UHasselt-imo-imomec/Hybrid_E-Tattoo-Hub/BachelorProject/ppt_BP_EA-ICT_Jorissen.pdf

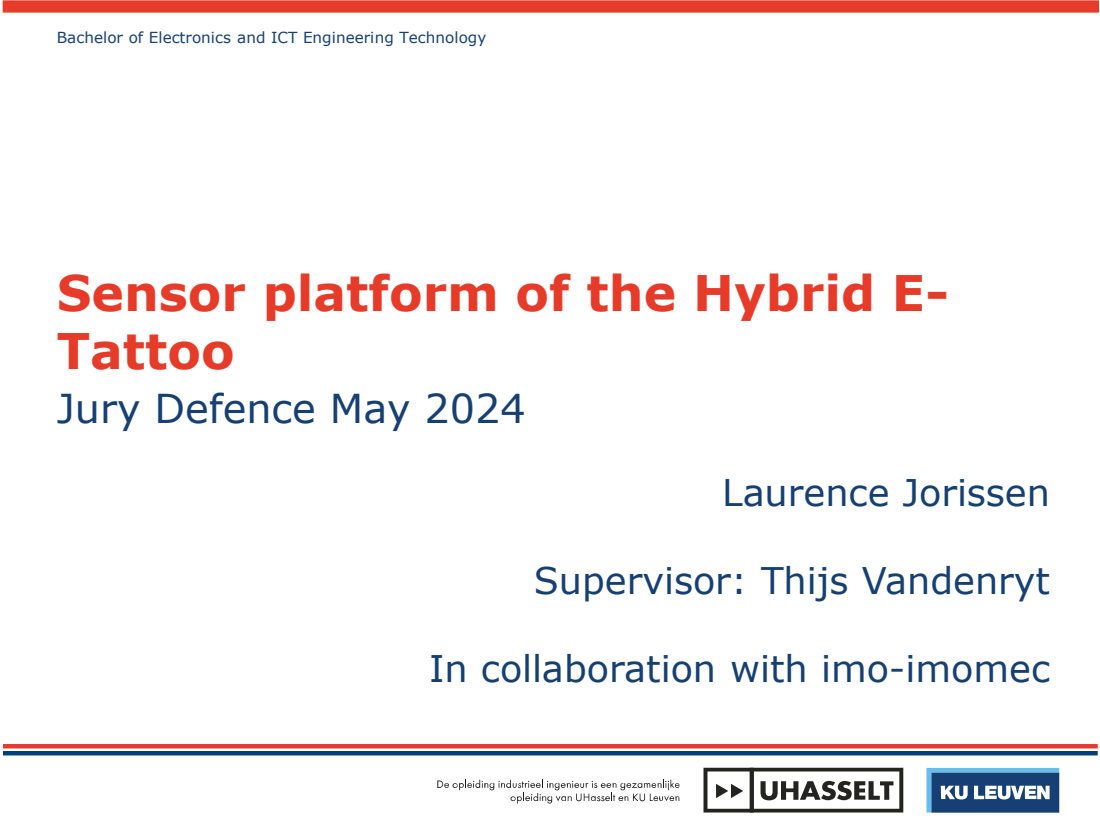
[picture p21: page 1]
Laurence Jorissen

Bachelor of Electronics and ICT Engineering Technology

Sensor platform of the Hybrid E-
Tattoo
Jury Defence May 2024

Supervisor: Thijs Vandenryt

In collaboration with imo-imomec

- The Hybrid E-Tattoo project
- Wearable Plug and Play healthcare device
- Health monitoring
- Combining smart textile and E-Tattoos (skin adhesives)

# Introduction

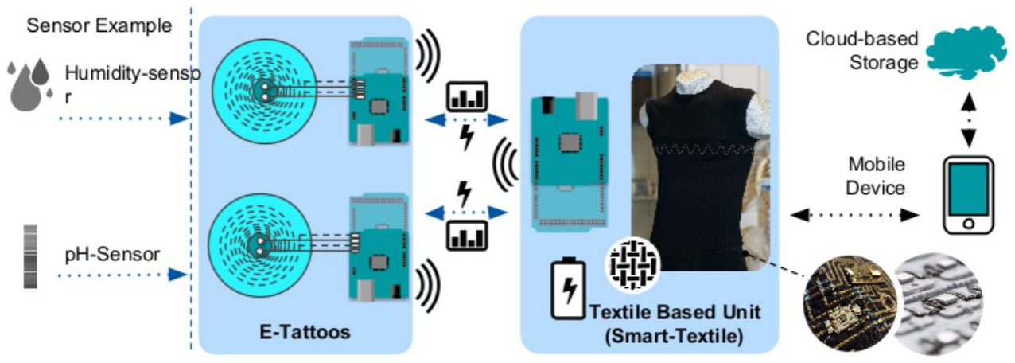
[picture p22: figure]

- The Hybrid E-Tattoo project
- Wearable plug and play healthcare device
- Health monitoring
- Combining smart textile and E-Tattoos (skin adhesives)

# Introduction

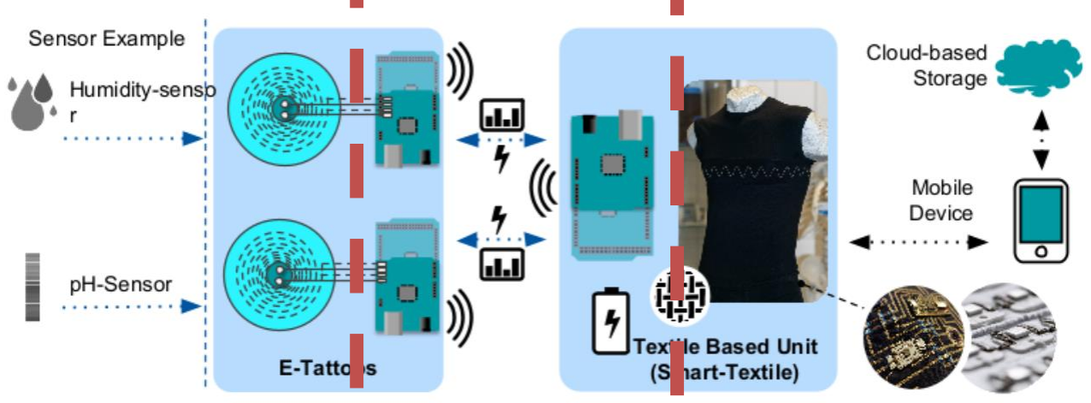
[picture p23: figure]

Sensor hub?

# Goal

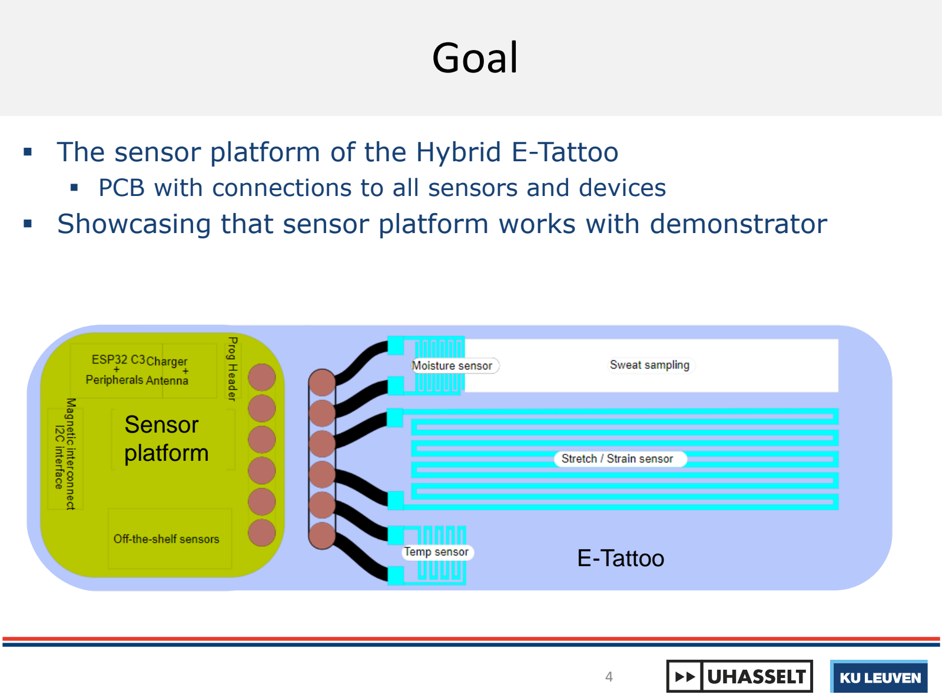
[picture p24: page 4]

- The sensor platform of the Hybrid E-Tattoo
- PCB with connections to all sensors and devices
- Showcasing that sensor platform works with demonstrator

E-Tattoo

Sensor
platform

- The demonstrator

# Materials & Results

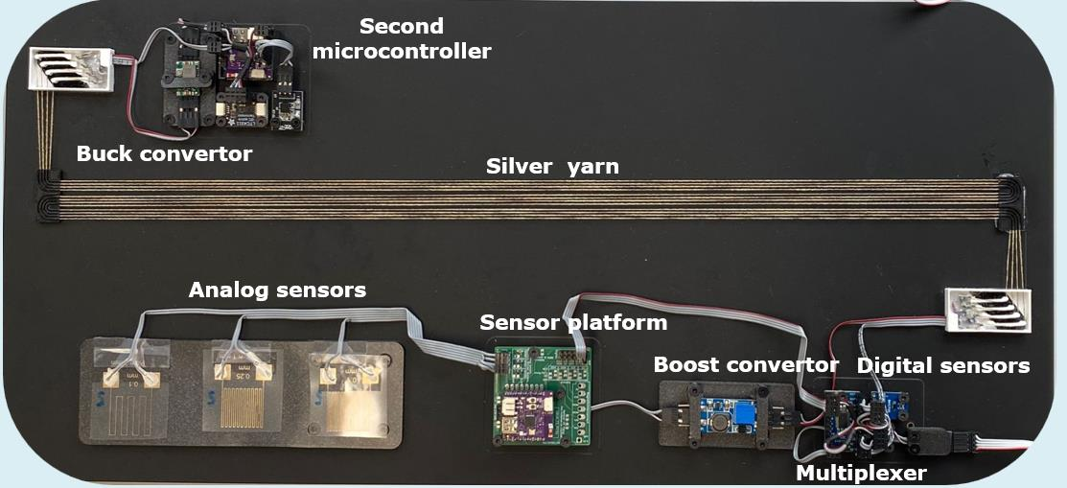
[picture p25: figure]

- The sensor platform (hub)

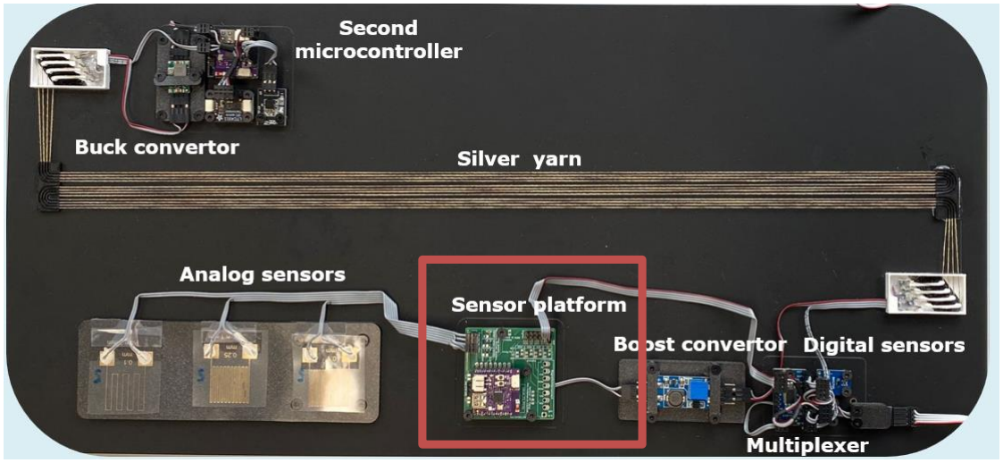
[picture p26: figure]

# Materials & Results

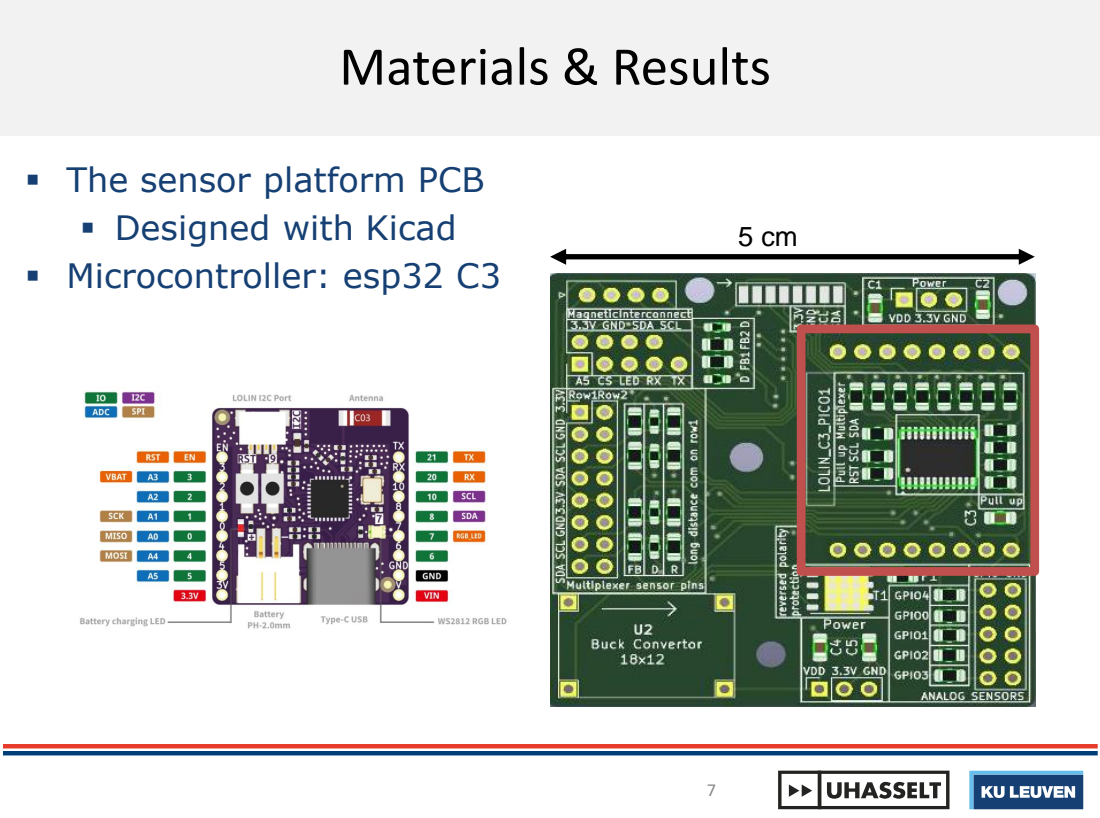
[picture p27: page 7]

▪ The sensor platform PCB
▪ Designed with Kicad
▪ Microcontroller: esp32 C3

- The analog sensors

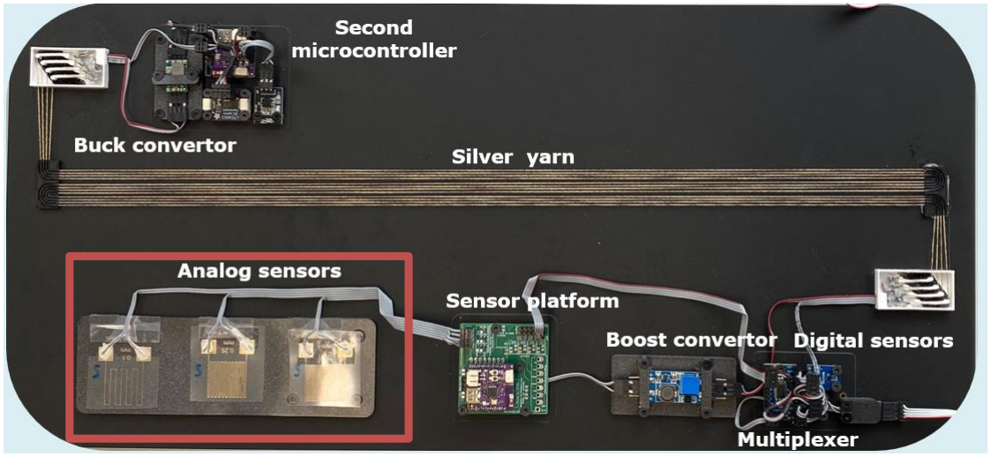
[picture p28: figure]

## - Screen printed analog Temperature sensors

# Materials & Results

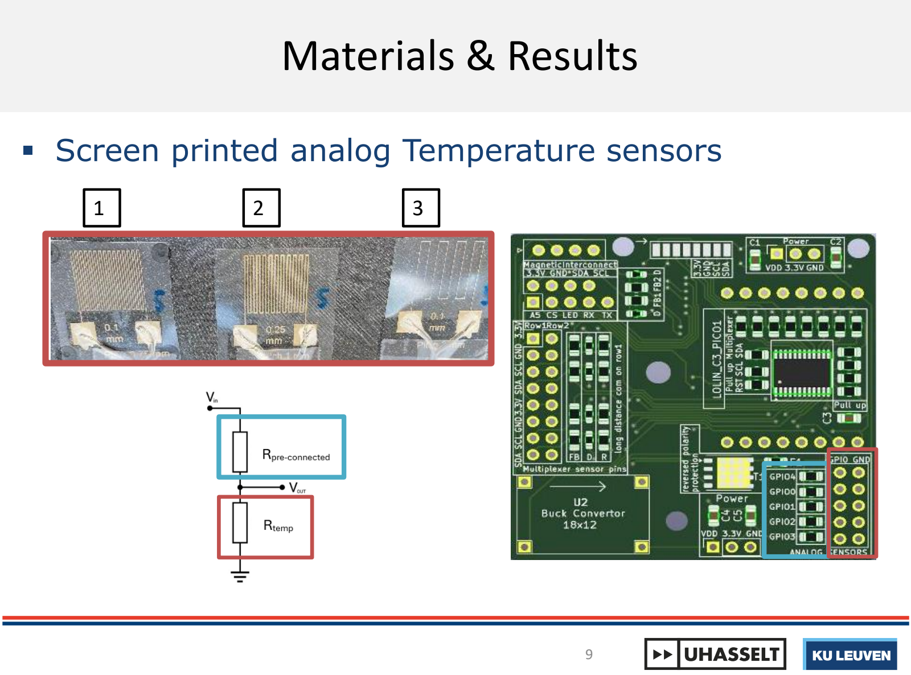
[picture p29: page 9]

1 | 2 | 3

## - Screen printed analog Temperature sensors

# Materials & Results

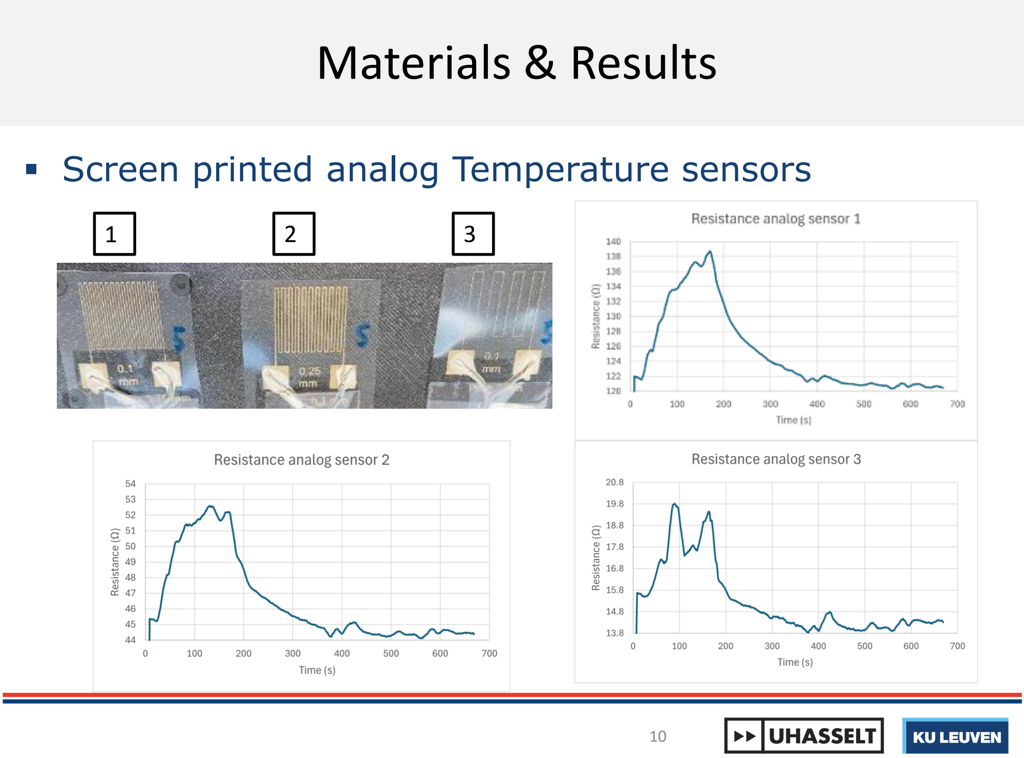
[picture p30: page 10]

1 | 2 | 3

- The digital sensors and multiplexer

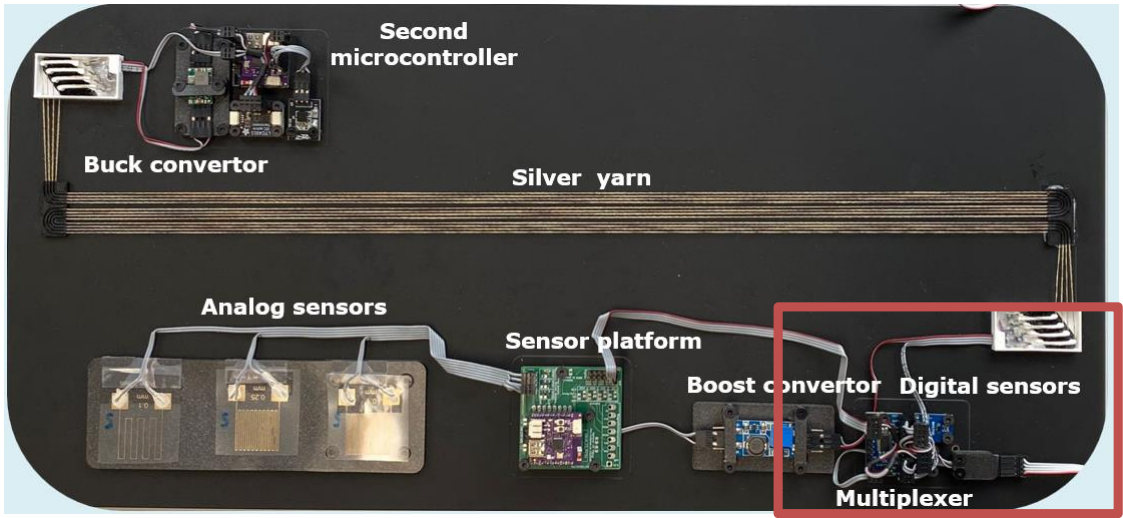
[picture p31: figure]

# Materials & Results

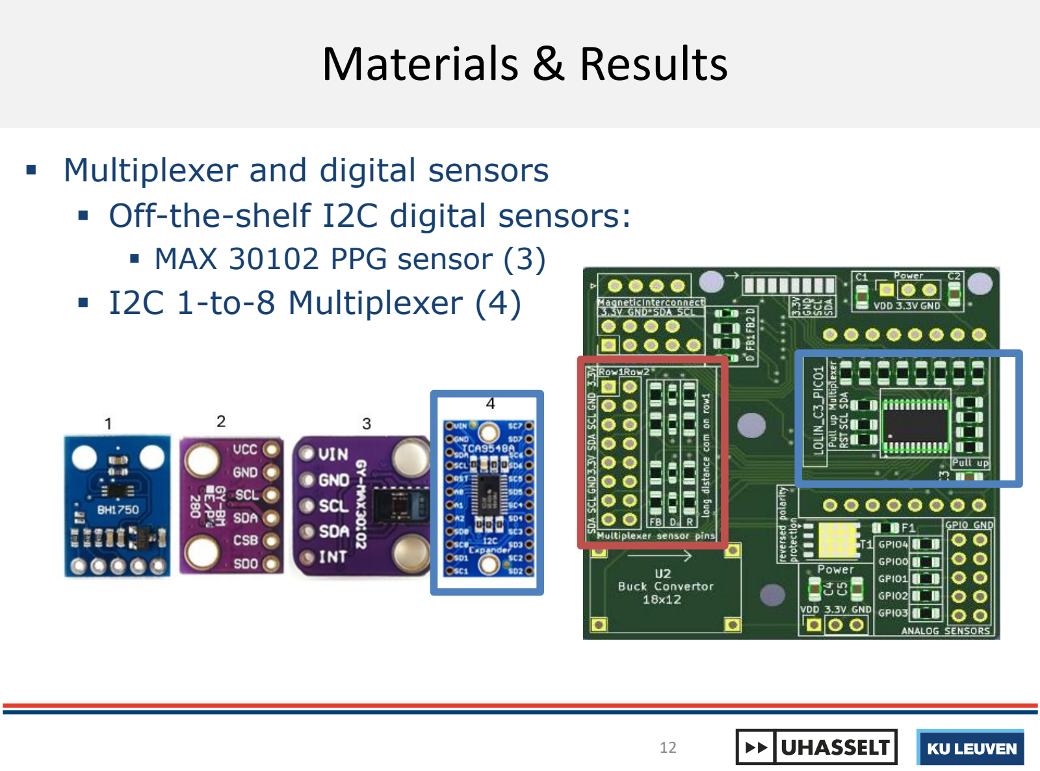
[picture p32: page 12]

### - Multiplexer and digital sensors - Off-the-shelf I2C digital sensors:

- MAX 30102 PPG sensor (3)

### - I2C 1-to-8 Multiplexer (4)

- The digital sensors and the multiplexer
- PPG sensor:
- Cable length +2 meters
- Continuous data

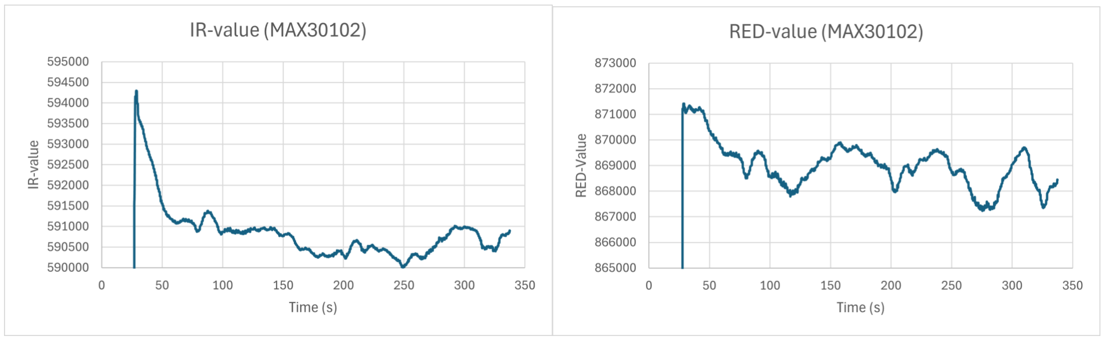
[picture p33: figure]

- The demonstrator

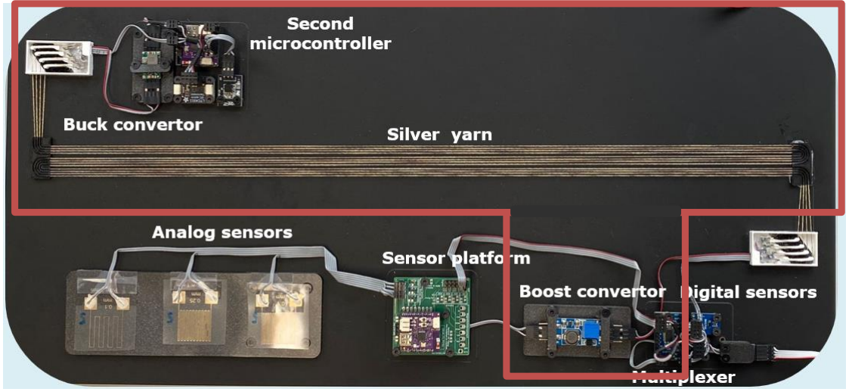
[picture p34: figure]

# Materials & Results

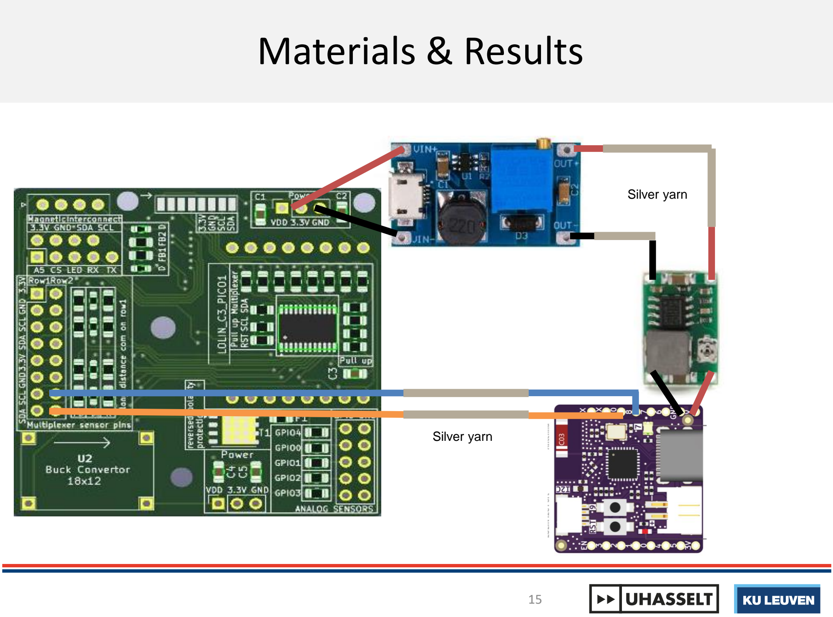
[picture p35: page 15]

Silver yarn

Silver yarn

- Communication to second microcontroller throughout silver yarn
- Here is where problems occurred
- Second microcontroller was powered and collected its data
- Unable to send its data back to sensor platform through only silver yarn (1)
- Able to send its data back through silver yarn where the ground was connected with a normal wire (2)

- Communication to second microcontroller throughout silver yarn
- Here is where problems occurred
- Second microcontroller was powered and collected its data
- Unable to send its data back to sensor platform through only silver yarn (1)
- Able to send its data back through silver yarn where the ground was connected with a normal wire (2)

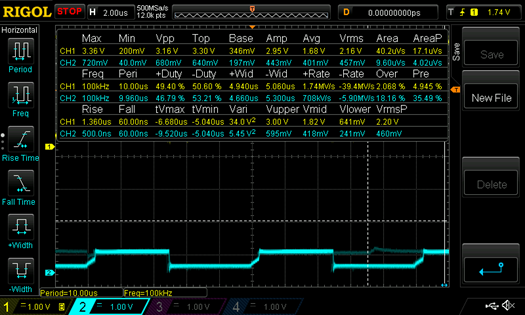
[picture p36: figure]

1

# Materials & Results

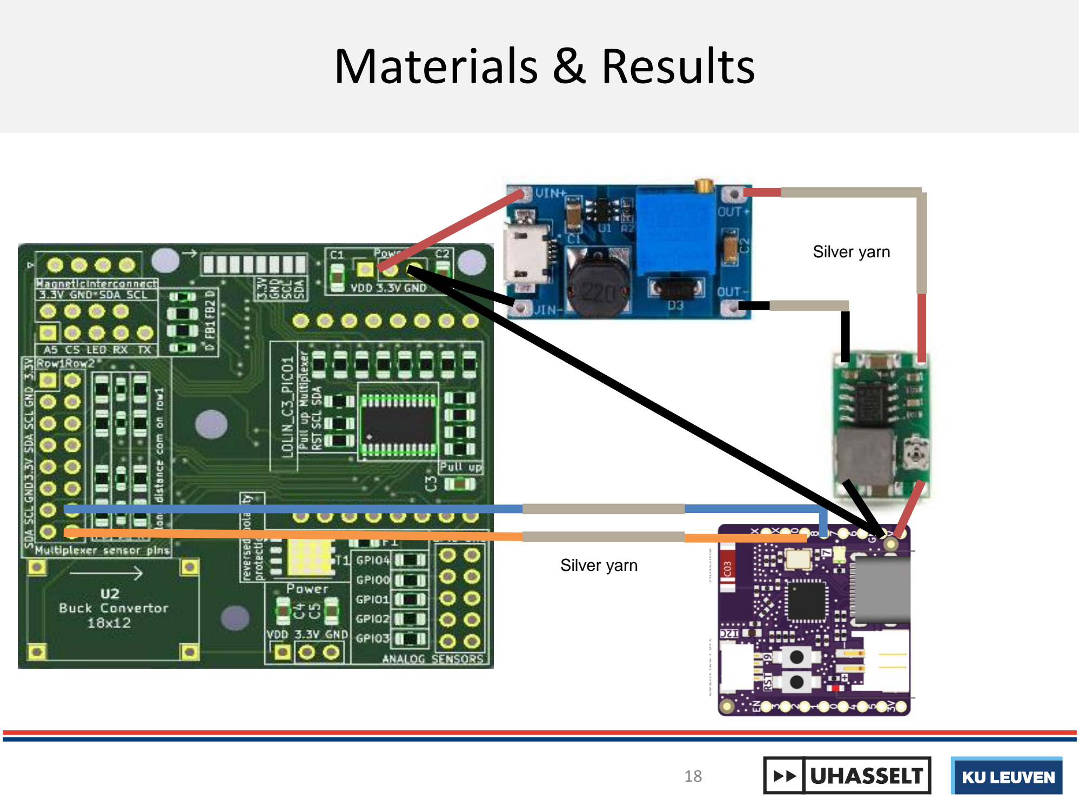
[picture p37: page 18]

Silver yarn

Silver yarn

- Communication to second microcontroller throughout silver yarn
- Here is where problems occurred
- Second microcontroller was powered and collected its data
- Unable to send its data back to sensor platform through only silver yarn (1)
- Able to send its data back through silver yarn where the ground was connected with a normal wire (2)

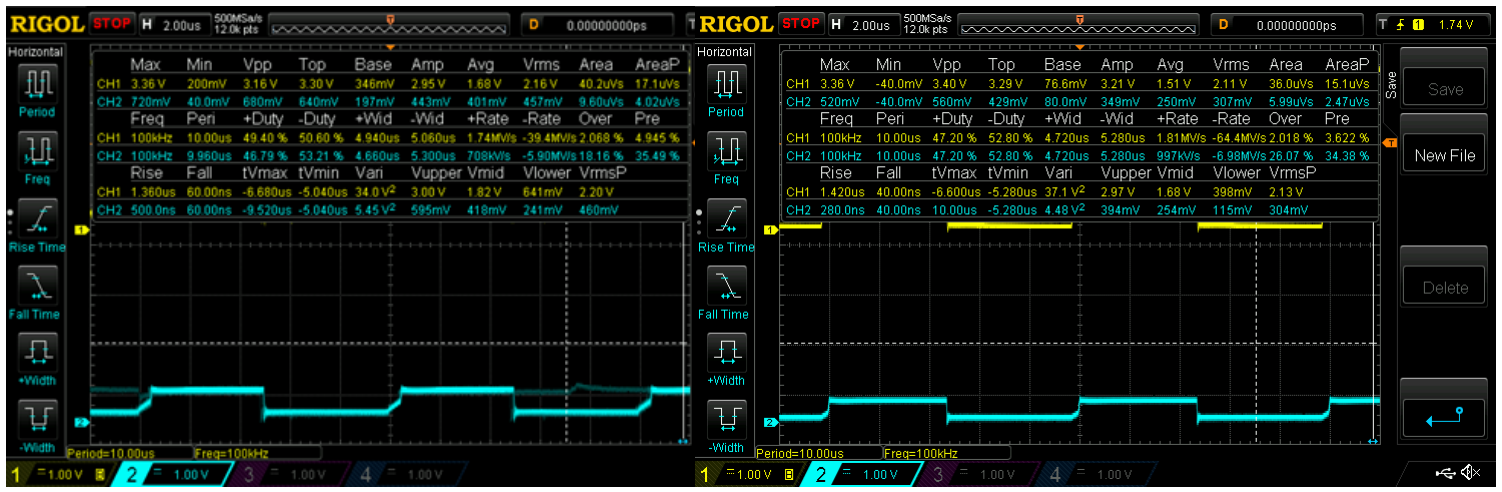
[picture p38: figure]

1 | 2

- Communication to second microcontroller throughout silver yarn
- Here is where problems occurred
- Second microcontroller was powered and collected its data
- Unable to send its data back to sensor platform through only silver yarn (1)
- Able to send its data back through silver yarn where the ground was connected with a normal wire (2)
- However, readout from sensor throughout silver yarn works

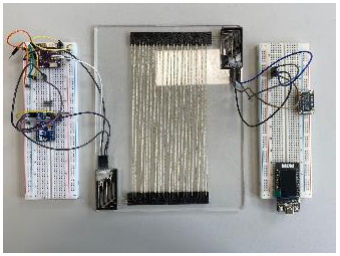
[picture p39: figure]
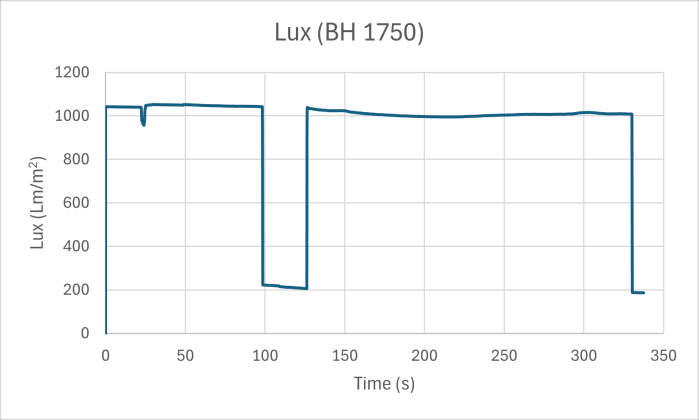
[picture p40: figure]
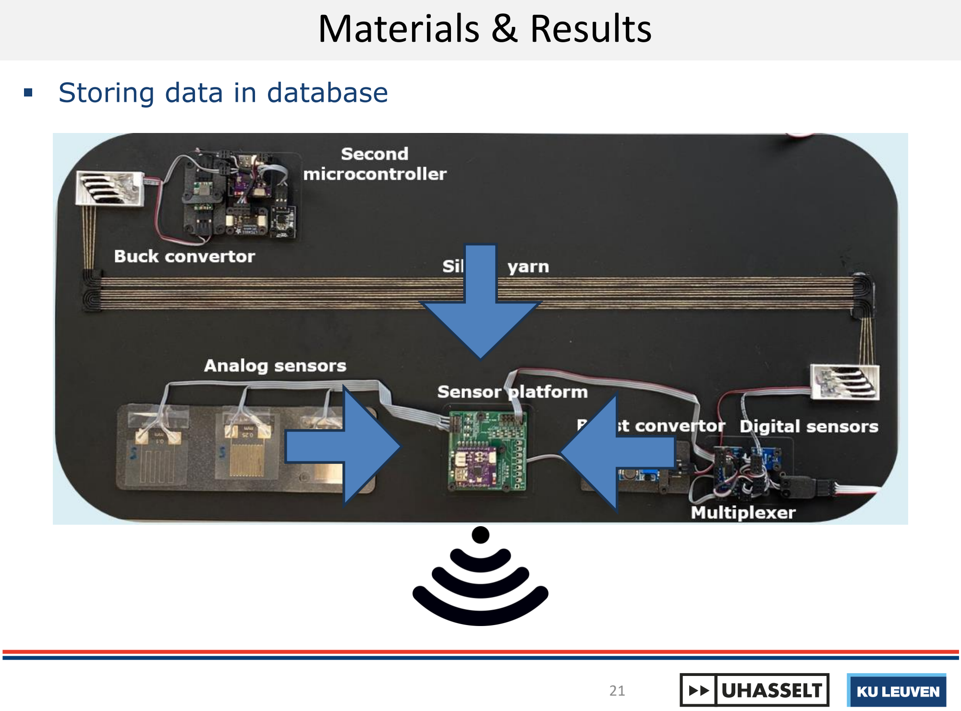
[picture p41: page 21]

- Storing data in database

## - Stroring data in database

### - InfluxDB

- Open-source time series database

# Materials & Results

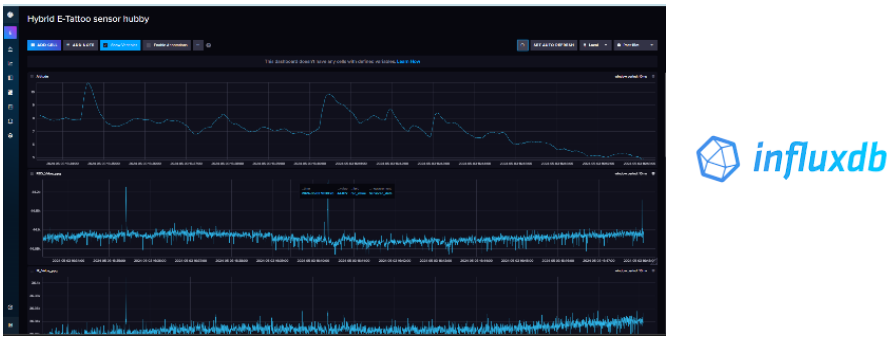
[picture p42: figure]

- The sensor platform fulfilled its role in the Hybrid E-Tattoo project
- For the readout of the sensors
- Not for the second microcontroller
- Designed from electronic perspective
- User cases introduced -> design adapted accordingly
- Room for optimalization in every part of demonstrator
- Analog sensors: Resolution can be optimized by ADC attenuation or with different pre-connected resistor values
- Digital sensors: Calibration of sensors can be optimized

# Conclusion

# Conclusion

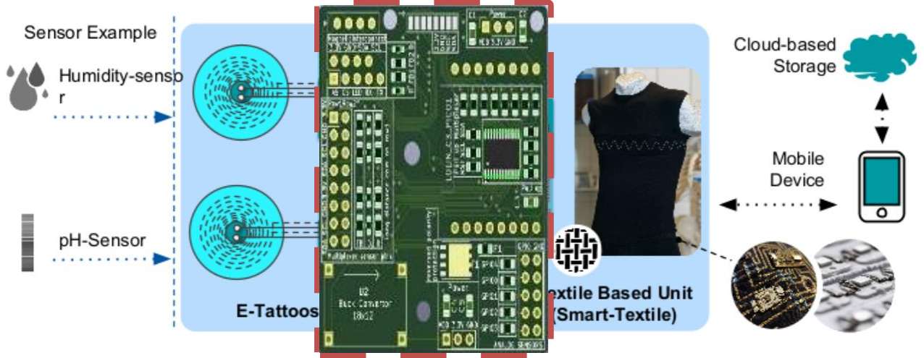
[picture p43: figure]

Sensor hub!

- The sensor platform
- 5 x 5 cm custom PCB
- Connections to all external sensors and devices
- Not of the same prototype as the one used on the demonstrator
- More optimized
- Multiplexer chip, security and long-distance communication components
- Transistor and fuse
- Pull up resistors
- Ferrite beads
- ESD suppressors

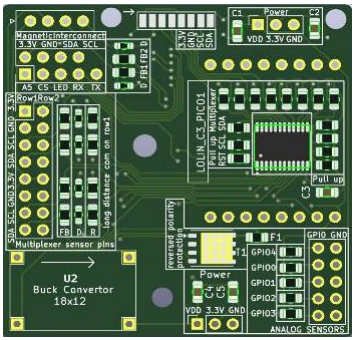
[picture p44: figure]

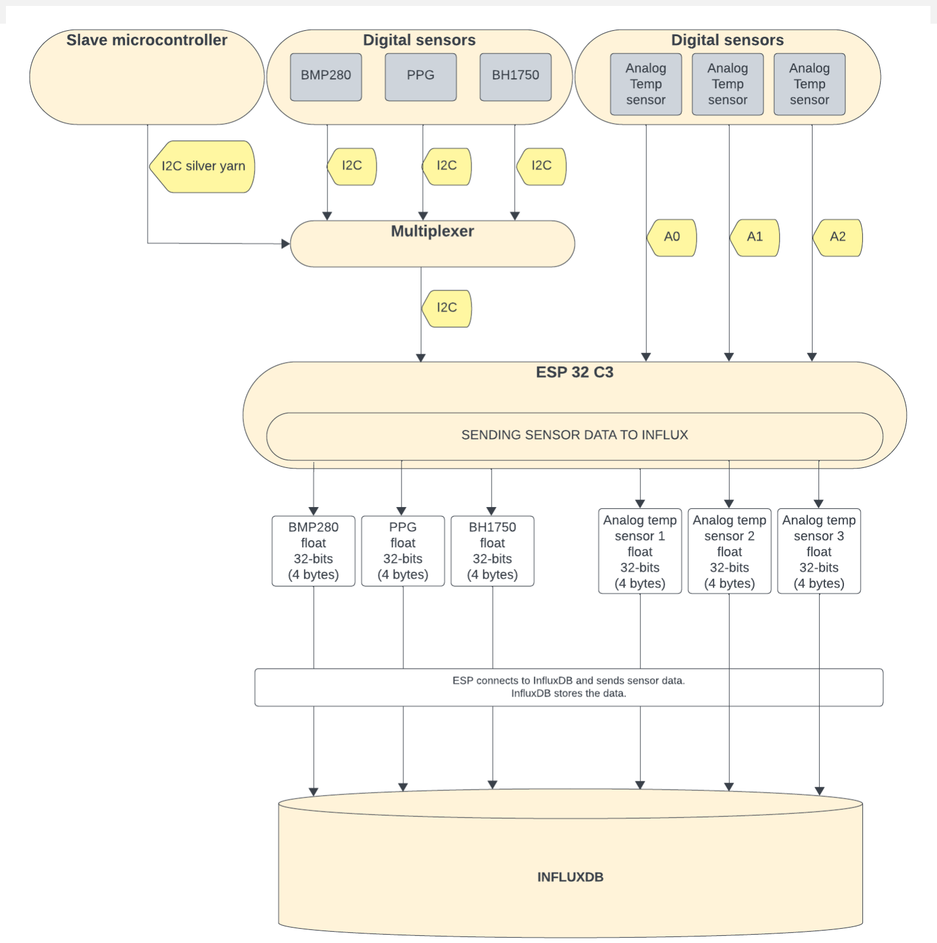
[picture p45: figure]
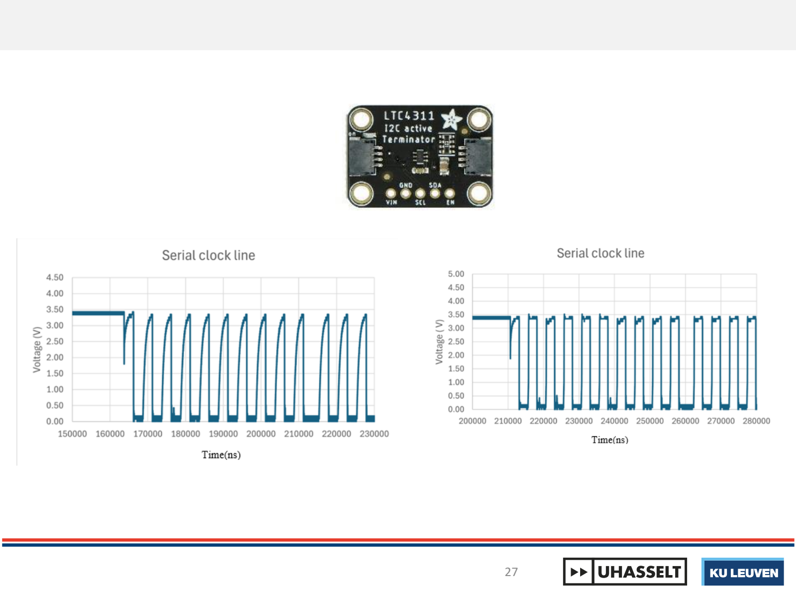
[picture p46: page 27]
