UHasselt-imo-imomec/Hybrid_E-Tattoo-Hub/Demonstrator_HardwareDesign/PCB_Laurence_V2.png

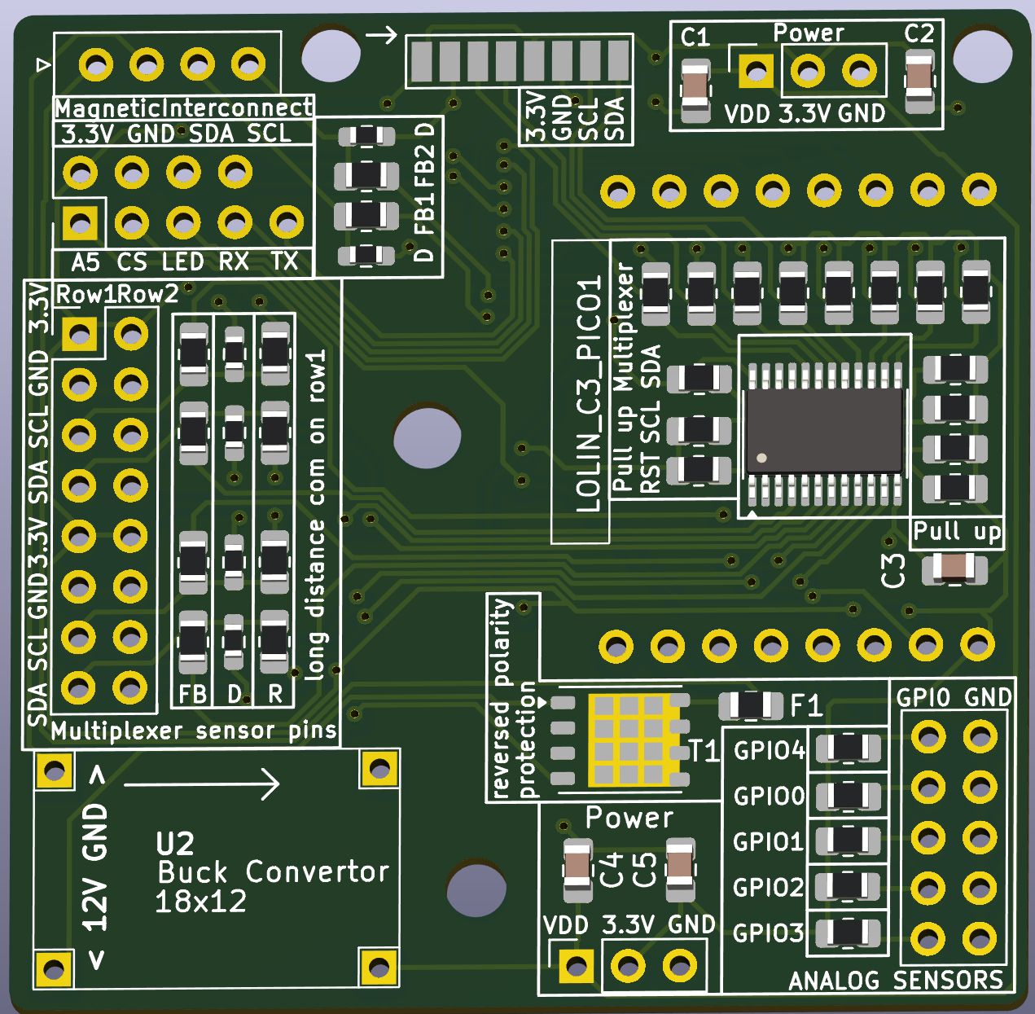
Demonstrator_HardwareDesign/PCB_Laurence_V2.png
