UHasselt-imo-imomec/Hybrid_E-Tattoo-Hub/Demonstrator_HardwareDesign/PCB_V1/CarrierPCB_Layers_Rear.png

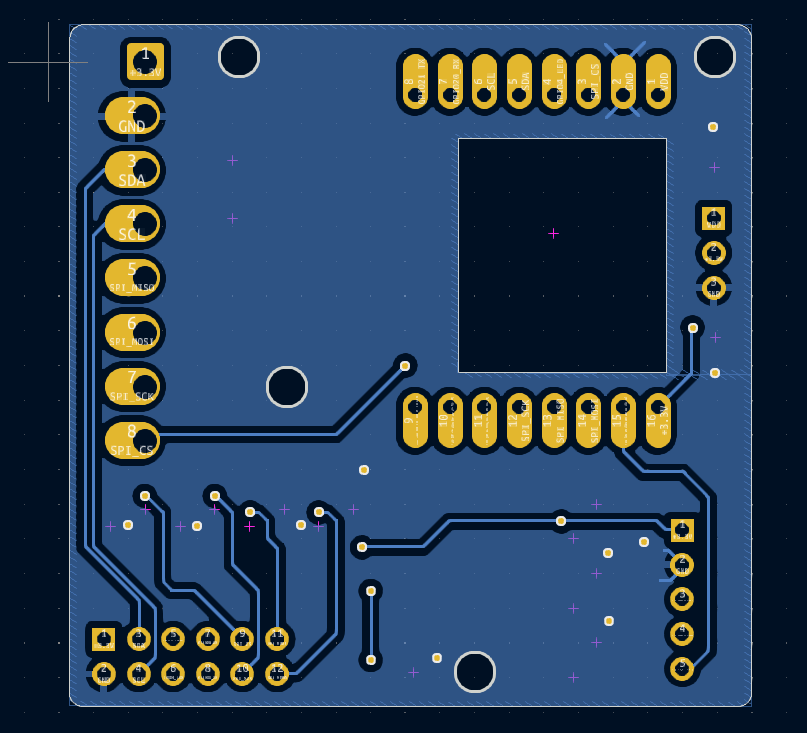
Demonstrator_HardwareDesign/PCB_V1/CarrierPCB_Layers_Rear.png
