UHasselt-imo-imomec/Hybrid_E-Tattoo-Hub/Demonstrator_HardwareDesign/Hybrid E-tattoo Hub V2_0/BOM.xls

WINKELWAGENTJE
Dit is geen factuur
29-mrt-24 05:02:43
 | Mouser-nr | Fabrikantnr | Fabrikant | Klantnummer | Omschrijving | RoHS | Levenscyclus | Besteld aantal | Prijs (EUR) | Toestel: (EUR)
1 | 595-TCA9548APWR | TCA9548APWR | Texas Instruments |  | Schakelaar IC&apos;s - Diversen 8-Channel I2C Switch | RoHS-conformiteit |  | 5 | 1,49 € | 7,45 €
2 | 710-742792693 | 742792693 | Wurth Elektronik |  | Ferrietparels WE-CBF 0603 100MHz 2200Ohm 50mA AEC-Q200 | RoHS-conformiteit |  | 30 | 0,17 € | 5,10 €
3 | 581-08056C106MAT2A | 08056C106MAT2A | KYOCERA AVX |  | Meerlaagse keramische condensatoren MLCC - SMD/SMT 6.3V 10uF X7R 0805 20% | RoHS-conformiteit |  | 30 | 0,117 € | 3,51 €
4 | 755-VS3V3BL1HST15R | VS3V3BL1HST15R | ROHM Semiconductor |  | ESD-onderdrukkers/TVS-diodes TVS DIODE HI-SURGE RESISTANCE | RoHS-conformiteit |  | 30 | 0,229 € | 6,87 €
5 | 708-RNCP0805FTD10K0 | RNCP0805FTD10K0 | SEI Stackpole |  | Weerstanden met dunne folie - SMD 10KOhms 0805 0.25W 100ppm 1% Hi Pwr Anti-Sulfur | RoHS-conformiteit | Nieuw bij Mouser | 50 | 0,021 € | 1,05 €
6 | 603-RT0805FRE073K3L | RT0805FRE073K3L | YAGEO |  | Weerstanden met dunne folie - SMD 1/8W 3.3K ohm 1% 50ppm | RoHS-conform per uitzondering |  | 50 | 0,027 € | 1,35 €
7 | 603-RT0805FRE071KL | RT0805FRE071KL | YAGEO |  | Weerstanden met dunne folie - SMD 1/8W 1K ohm 1% 50ppm | RoHS-conform per uitzondering |  | 50 | 0,027 € | 1,35 €
8 | 726-BSZ086P03NS3GXT | BSZ086P03NS3GXT | Infineon |  | MOSFET P-Ch -30V 13.5A TSDSON-8 OptiMOS P3 | RoHS-conformiteit |  | 10 | 0,654 € | 6,54 €
9 | 581-F0805B0R50FSTR | F0805B0R50FSTR | KYOCERA AVX |  | Opbouwzekeringen 0805 0.5AMPS SMD | RoHS-conformiteit |  | 10 | 0,483 € | 4,83 €
Door uw bestelling te verzenden, gaat u akkoord met deze bepalingen en voorwaarden. (https://eu.mouser.com/saleterms) |  |  |  |  |  |  |  |  | Aangekochte artikelen: | 38,05 €
De getoonde prijzen zijn gekoppeld aan de weergegeven datum en tijd. |  |  |  |  |  |  |  |  | Verzendkosten: | 20,00 €
