UHasselt-imo-imomec/Hybrid_E-Tattoo-Hub/Data/Data_ppg_ESP32C3/Derde test data met klipper/ppg_data_met_klipper.xlsx

Sheet: ppg data lange afstand alle sen
Column1 | Column2 | Column3
318696 | 595588 | 869345
318826 | 595593 | 869346
318956 | 595577 | 869357
319086 | 595590 | 869355
319217 | 595505 | 869051
319365 | 595499 | 869047
319495 | 595495 | 869042
319625 | 595494 | 869045
319755 | 595497 | 869049
319886 | 595505 | 869043
320016 | 595517 | 868974
320146 | 595521 | 868971
320276 | 595526 | 868973
320406 | 595524 | 868966
320541 | 595517 | 868968
320671 | 595524 | 868970
320801 | 595590 | 869130
320931 | 595603 | 869134
321062 | 595600 | 869144
321192 | 595592 | 869132
321323 | 595582 | 869103
321453 | 595564 | 869040
321584 | 595564 | 868943
321714 | 595568 | 868969
321844 | 595573 | 868977
321975 | 595570 | 868987
322105 | 595574 | 868999
322236 | 595582 | 869012
322366 | 595554 | 868913
322497 | 595560 | 868921
322632 | 595562 | 868923
322762 | 595568 | 868941
322893 | 595568 | 868942
323023 | 595577 | 868990
323153 | 595575 | 868986
323284 | 595574 | 868981
323414 | 595573 | 868982
323545 | 595572 | 868997
323675 | 595574 | 868992
323806 | 595647 | 869217
323936 | 595645 | 869220
324067 | 595653 | 869249
324197 | 595655 | 869256
324328 | 595661 | 869275
324458 | 595664 | 869278
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
