UHasselt-imo-imomec/Hybrid_E-Tattoo-Hub/Data/Data_ppg_ESP32C3/Eerste test data/PPG_data op korte afstand.csv

#! | Workbook: | Custom | Custom
#! | Deze gegevens afspelen: open het oorspronkelijke Excel-werkmapbestand | klik op de knop *Gegevensbestand importeren* op het lint *Data Streamer* en navigeer naar dit bestand.
#! | Ga naar http://aka.ms/hackingstem/ voor meer informatie
1431424 | 1986666
1431432 | 1986665
1431433 | 1986667
1431429 | 1986659
1431435 | 1986662
1431432 | 1986654
1431434 | 1986662
1431433 | 1986664
1431425 | 1986656
1431430 | 1986657
1431435 | 1986659
1431436 | 1986657
1431426 | 1986650
1431445 | 1986617
1431436 | 1986650
1431426 | 1986664
1431426 | 1986660
1431427 | 1986658
1431437 | 1986655
1431433 | 1986670
1431439 | 1986667
1431430 | 1986645
1431423 | 1986654
1431428 | 1986658
1431425 | 1986653
1431434 | 1986663
1431425 | 1986640
1431422 | 1986658
1431426 | 1986663
1431425 | 1986652
1431423 | 1986658
1431428 | 1986659
1431425 | 1986650
1431426 | 1986658
1431424 | 1986650
1431429 | 1986661
1431438 | 1986671
1431426 | 1986662
1431430 | 1986660
1431430 | 1986659
1431428 | 1986647
1431429 | 1986654
1431426 | 1986653
1431426 | 1986655
1431434 | 1986603
1431417 | 1986648
1431428 | 1986656
1431428 | 1986641
1431428 | 1986654
1431428 | 1986658
1431427 | 1986661
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
