UHasselt-imo-imomec/Hybrid_E-Tattoo-Hub/Data/Data_ppg_ESP32C3/Eerste test data/PPG_data op lange afstand zonder LTC.csv

#! | Workbook: | Custom | Custom
#! | Deze gegevens afspelen: open het oorspronkelijke Excel-werkmapbestand | klik op de knop *Gegevensbestand importeren* op het lint *Data Streamer* en navigeer naar dit bestand.
#! | Ga naar http://aka.ms/hackingstem/ voor meer informatie
1150719 | 1703317
1150709 | 1703317
1150721 | 1703260
1150715 | 1703298
1150719 | 1703310
1150709 | 1703291
1150716 | 1703301
1150713 | 1703299
1150702 | 1703292
1150722 | 1703313
1150693 | 1703279
1150703 | 1703275
1150702 | 1703273
1150700 | 1703281
1150705 | 1703265
1150712 | 1703292
1150696 | 1703287
1150692 | 1703276
1150690 | 1703282
1150679 | 1703266
1150691 | 1703273
1150686 | 1703271
1150674 | 1703254
1150684 | 1703281
1150680 | 1703262
1150665 | 1703240
1150679 | 1703255
1150689 | 1703251
1150679 | 1703261
1150686 | 1703258
1150675 | 1703255
1150683 | 1703253
1150687 | 1703272
1150686 | 1703192
1150673 | 1703250
1150677 | 1703243
1150677 | 1703239
1150675 | 1703244
1150679 | 1703242
1150686 | 1703238
1150688 | 1703243
1150645 | 1703195
1150646 | 1703189
1150645 | 1703192
1150645 | 1703194
1150641 | 1703183
1150642 | 1703179
1150641 | 1703159
1150647 | 1703186
1150622 | 1703156
1150639 | 1703177
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
