UHasselt-imo-imomec/Hybrid_E-Tattoo-Hub/Data/Data_ppg_ESP32C3/Eerste test data/PPG_data op super lange afstand met LTC zonder mult.csv

#! | Workbook: | Custom | Custom
#! | Deze gegevens afspelen: open het oorspronkelijke Excel-werkmapbestand | klik op de knop *Gegevensbestand importeren* op het lint *Data Streamer* en navigeer naar dit bestand.
#! | Ga naar http://aka.ms/hackingstem/ voor meer informatie
1131122 | 1423428
1131116 | 1423428
1131119 | 1423423
1131116 | 1423427
1131115 | 1423427
1131119 | 1423428
1131119 | 1423430
1131111 | 1423432
1131121 | 1423430
1131123 | 1423436
1131116 | 1423426
1131119 | 1423427
1131119 | 1423425
1131116 | 1423424
1131119 | 1423418
1131096 | 1423387
1131097 | 1423393
1131102 | 1423394
1131096 | 1423395
1131127 | 1423431
1131119 | 1423420
1131121 | 1423436
1131128 | 1423424
1131111 | 1423426
1131122 | 1423432
1131121 | 1423423
1131118 | 1423426
1131121 | 1423420
1131115 | 1423417
1131120 | 1423431
1131111 | 1423433
1131108 | 1423423
1131114 | 1423426
1131120 | 1423428
1131120 | 1423425
1131120 | 1423432
1131119 | 1423429
1131122 | 1423424
1131117 | 1423434
1131132 | 1423430
1131125 | 1423433
1131116 | 1423427
1131119 | 1423436
1131121 | 1423428
1131120 | 1423423
1131122 | 1423429
1131121 | 1423433
1131121 | 1423428
1131123 | 1423429
1131122 | 1423434
1131123 | 1423429
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
