UHasselt-imo-imomec/Hybrid_E-Tattoo-Hub/Data/Data_ppg_ESP32C3/Eerste test data/PPG_data op super lange afstand zonder LTC en zonder Multiplexer.csv

#! | Workbook: | Custom | Custom
#! | Deze gegevens afspelen: open het oorspronkelijke Excel-werkmapbestand | klik op de knop *Gegevensbestand importeren* op het lint *Data Streamer* en navigeer naar dit bestand.
#! | Ga naar http://aka.ms/hackingstem/ voor meer informatie
1162632 | 1990161
1162627 | 1990168
1162624 | 1990167
1162631 | 1990171
1162632 | 1990163
1162626 | 1990176
1162631 | 1990173
1162640 | 1990172
1162634 | 1990172
1162638 | 1990172
1162640 | 1990168
1162631 | 1990171
1162622 | 1990168
1162638 | 1990179
1162629 | 1990177
1162635 | 1990166
1162629 | 1990172
1162636 | 1990169
1162629 | 1990164
1162624 | 1990171
1162633 | 1990167
1162631 | 1990167
1162632 | 1990164
1162629 | 1990176
1162630 | 1990162
1162628 | 1990172
1162630 | 1990171
1162626 | 1990164
1162626 | 1990166
1162629 | 1990171
1162631 | 1990174
1162624 | 1990168
1162619 | 1990173
1162629 | 1990175
1162634 | 1990167
1162633 | 1990178
1162632 | 1990186
1162641 | 1990172
1162629 | 1990178
1162626 | 1990173
1162635 | 1990158
1162628 | 1990174
1162626 | 1990170
1162629 | 1990172
1162632 | 1990157
1162627 | 1990166
1162641 | 1990176
1162624 | 1990174
1162628 | 1990173
1162624 | 1990174
1162622 | 1990159
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
