UHasselt-imo-imomec/Hybrid_E-Tattoo-Hub/Data/Data_ppg_ESP32C3/Derde test data met klipper/IR-Value met klipper.jpg

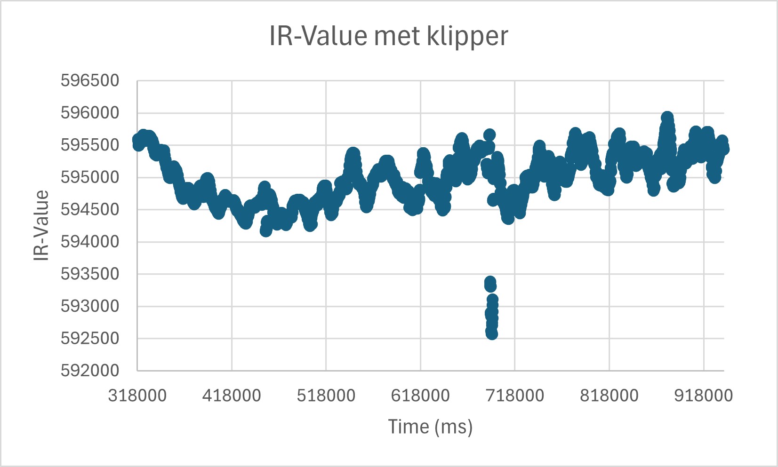
Data/Data_ppg_ESP32C3/Derde test data met klipper/IR-Value met klipper.jpg
