UHasselt-imo-imomec/Hybrid_E-Tattoo-Hub/Data/Data_ppg_ESP32C3/Eerste test data/PPG sensor op korte afstand.jpg

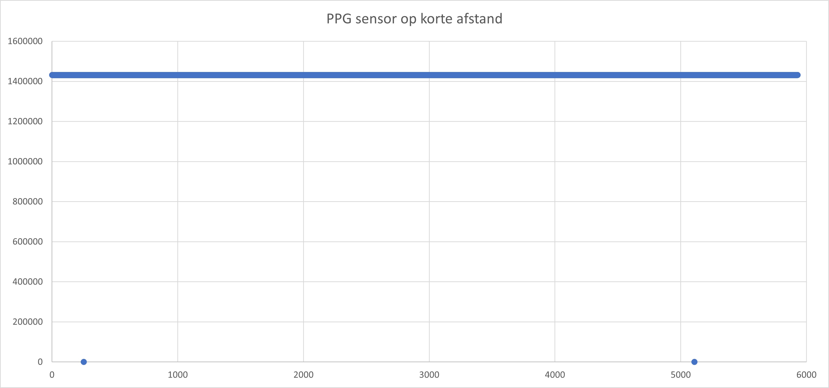
Data/Data_ppg_ESP32C3/Eerste test data/PPG sensor op korte afstand.jpg
