UHasselt-imo-imomec/Hybrid_E-Tattoo-Hub/Data/Data_ppg_ESP32C3/Eerste test data/PPG sensor op super lange afstand zonder LTC4311.jpg

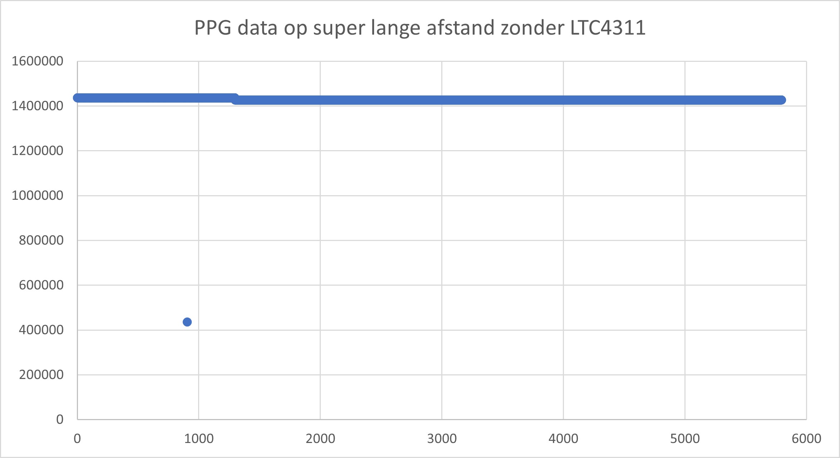
Data/Data_ppg_ESP32C3/Eerste test data/PPG sensor op super lange afstand zonder LTC4311.jpg
