UHasselt-imo-imomec/Hybrid_E-Tattoo-Hub/Data/Data_ppg_ESP32C3/Eerste test data/red_value zonder etc zonder multi.jpg

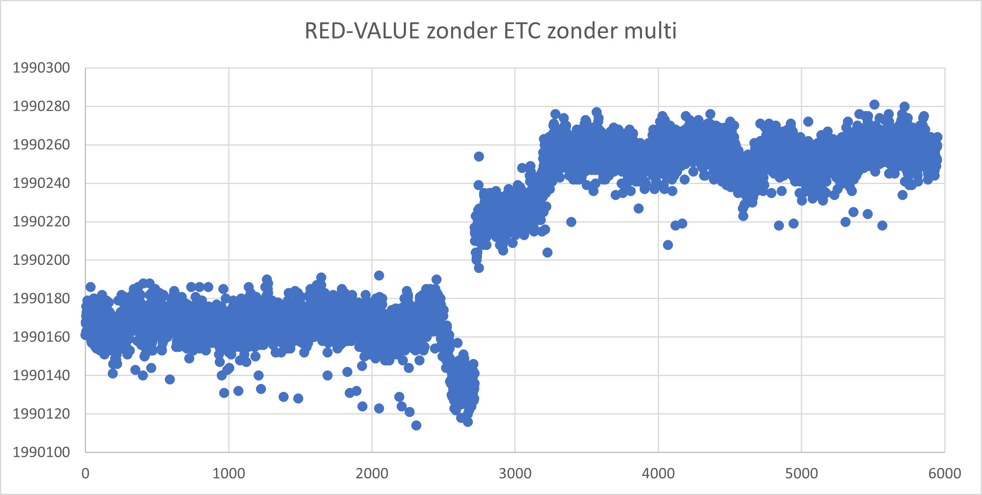
Data/Data_ppg_ESP32C3/Eerste test data/red_value zonder etc zonder multi.jpg
