UHasselt-imo-imomec/Hybrid_E-Tattoo-Hub/Data/Data_ppg_ESP32C3/Tweede test data/alle sensoren met multiplexer/IR-Value korte afstand.jpg

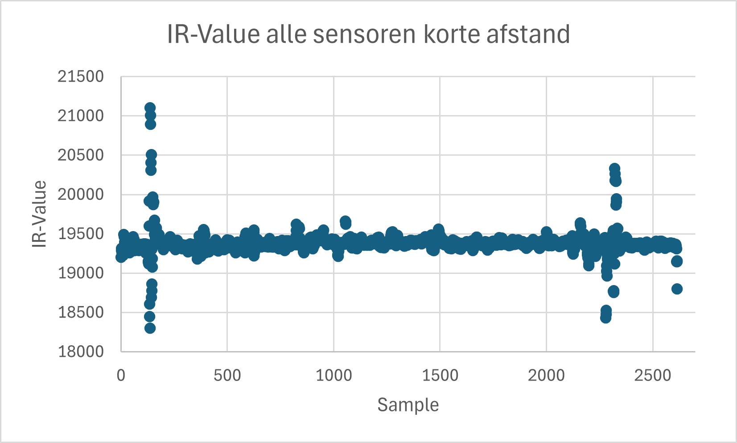
Data/Data_ppg_ESP32C3/Tweede test data/alle sensoren met multiplexer/IR-Value korte afstand.jpg
