UHasselt-imo-imomec/Hybrid_E-Tattoo-Hub/Data/Data_ppg_ESP32C3/Tweede test data/Alleen ppg sensor/IR-Value korte afstand.jpg

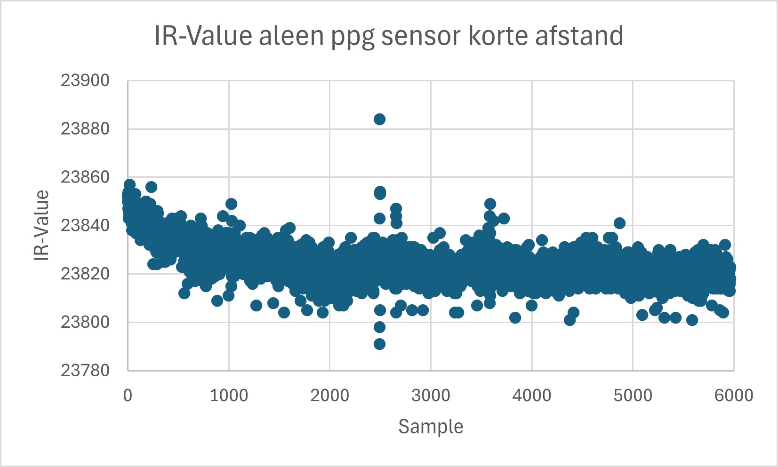
Data/Data_ppg_ESP32C3/Tweede test data/Alleen ppg sensor/IR-Value korte afstand.jpg
