UHasselt-imo-imomec/Hybrid_E-Tattoo-Hub/Data/Data_ppg_ESP32C3/Tweede test data/Alleen ppg sensor/RED-value lange afstand.jpg

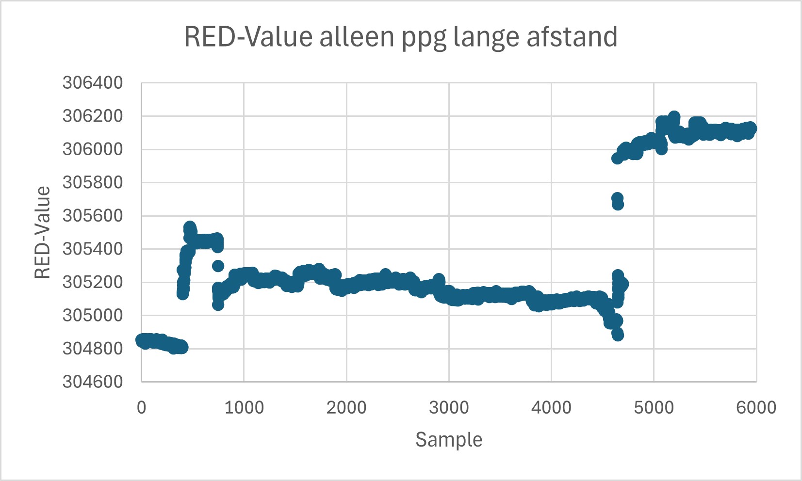
Data/Data_ppg_ESP32C3/Tweede test data/Alleen ppg sensor/RED-value lange afstand.jpg
