UHasselt-imo-imomec/Hybrid_E-Tattoo-Hub/Data/Dataflow/Dataflow_esp32.pdf

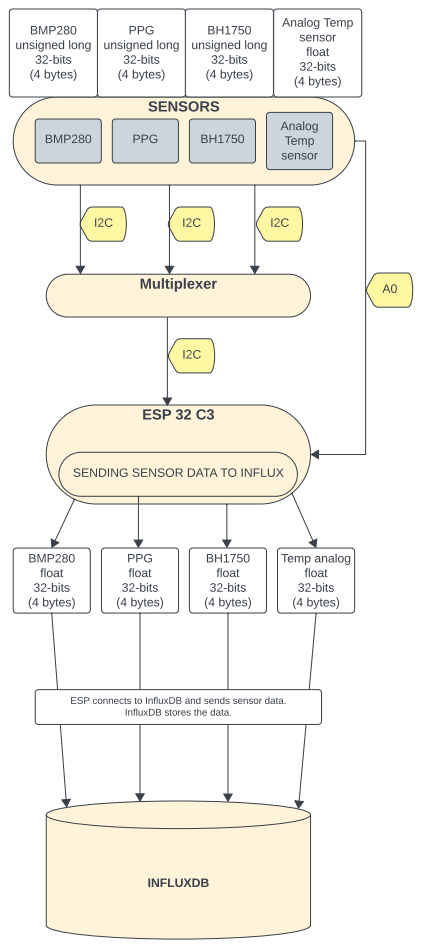
[picture p68: page 1]
ESP 32 C3; SENSORS; BMP280; PPG; INFLUXDB; Multiplexer; Analog Temp sensor; BMP280 float 32-bits (4 bytes); PPG unsigned long 32-bits (4 bytes); BH1750 unsigned long 32-bits (4 bytes); BMP280 unsigned long 32-bits (4 bytes); PPG float 32-bits (4 bytes); BH1750 float 32-bits (4 bytes); Temp analog float 32-bits (4 bytes); Analog Temp sensor float 32-bits (4 bytes)

SENDING SENSOR DATA TO INFLUX

ESP connects to InfluxDB and sends sensor data.

InfluxDB stores the data.
