UHasselt-imo-imomec/Hybrid_E-Tattoo-Hub/Demonstrator_HardwareDesign/Hybrid E-tattoo Hub V2_0/EHealth_PCB.kicad_pcb

## KiCad design Demonstrator_HardwareDesign/Hybrid E-tattoo Hub V2_0/EHealth_PCB.kicad_pcb (2024-10-08)

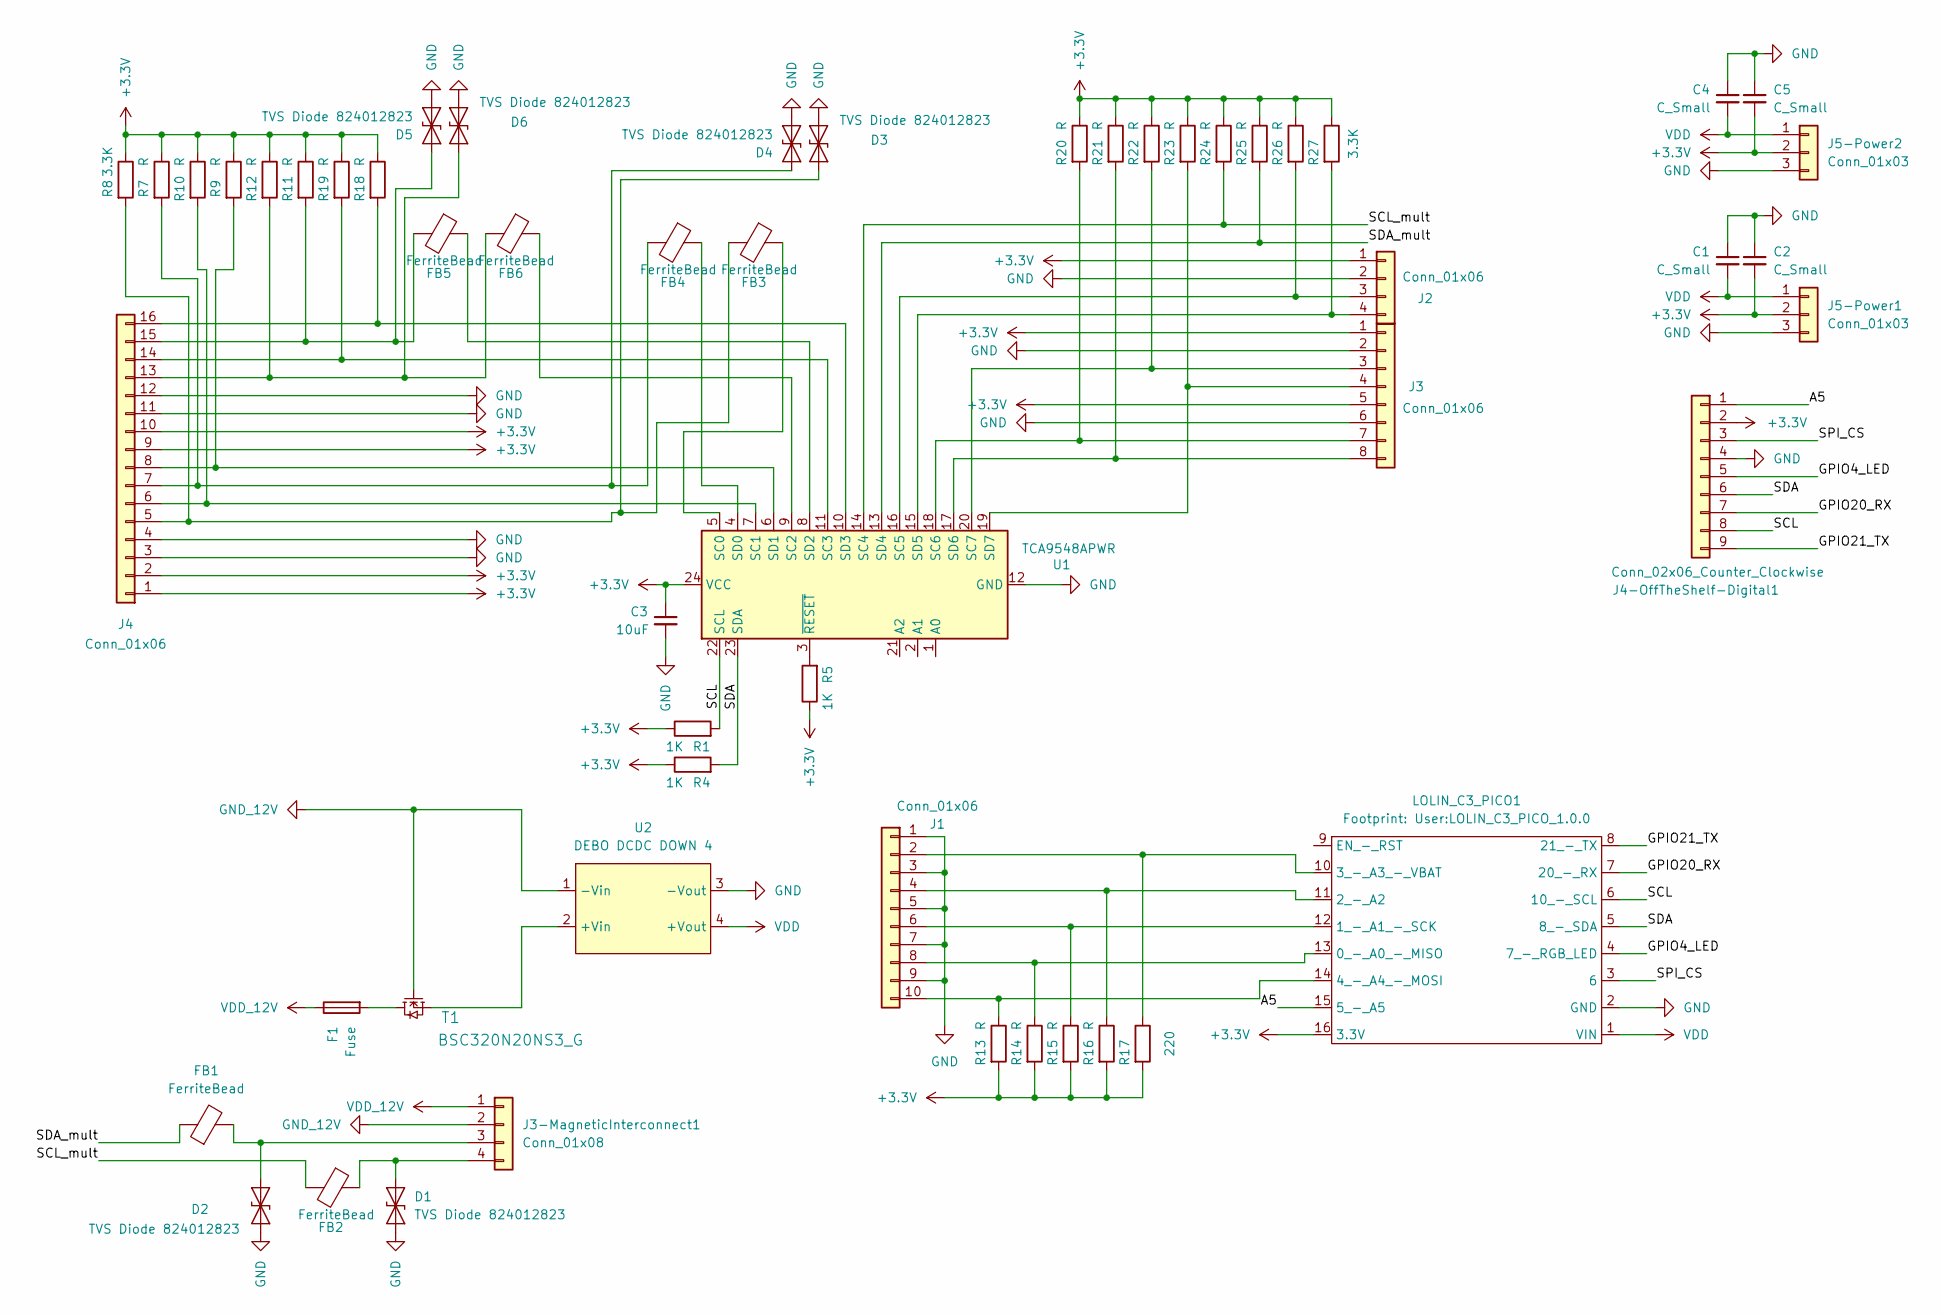
[picture p69: schematic EHealth_PCB.kicad_sch]

Parts:
C1, C2, C4, C5: C_Small; C_0805_2012Metric_Pad1.18x1.45mm_HandSolder
C3: 10uF; C_0805_2012Metric_Pad1.18x1.45mm_HandSolder
D1, D2, D3, D4, D5, D6: TVS Diode 824012823; R_0603_1608Metric_Pad0.98x0.95mm_HandSolder
F1: Fuse; Fuse_0805_2012Metric_Pad1.15x1.40mm_HandSolder
FB1, FB2, FB3, FB4, FB5, FB6: FerriteBead; R_0805_2012Metric_Pad1.20x1.40mm_HandSolder
J1: Conn_01x06; PinHeader_2x05_P2.54mm_Vertical
J2: Conn_01x06; PinHeader_1x04_P2.54mm_Vertical
J3: Conn_01x06; PinHeader_1x08_P2.54mm_Vertical
J3-MagneticInterconnect1: Conn_01x08; JST_VH_B4P-VH-B_1x04_P3.96mm_Vertical
J4: Conn_01x06; PinHeader_2x08_P2.54mm_Vertical
J4-OffTheShelf-Digital1: Conn_02x06_Counter_Clockwise; PinHeader_2x05_P2.54mm_Vertical
J5-Power1, J5-Power2: Conn_01x03; PinSocket_1x03_P2.54mm_Vertical
LOLIN_C3_PICO1: LOLIN_C3_PICO_1.0.0
R1, R4, R5: 1K; R_0805_2012Metric_Pad1.20x1.40mm_HandSolder
R7, R9, R10, R11, R12, R13, R14, R15, R16, R18, R19, R20, R21, R22, R23, R24, R25, R26: R; R_0805_2012Metric_Pad1.20x1.40mm_HandSolder
R8, R27: 3.3K; R_0805_2012Metric_Pad1.20x1.40mm_HandSolder
R17: 220; R_0805_2012Metric_Pad1.20x1.40mm_HandSolder
T1: BSC320N20NS3_G; Infineon_PG-TDSON-8_6.15x5.15mm; Voltage 200V
U1: TCA9548APWR; TSSOP-24_4.4x7.8mm_P0.65mm
U2: DEBO DCDC DOWN 4

Connections:
+3.3V: C2.2, C3.1, C5.2, J2.1, J3.1, J3.5, J4.1, J4.2, J4.9, J4.10, J4-OffTheShelf-Digital1.2, J5-Power1.2, J5-Power2.2, LOLIN_C3_PICO1.16 (3.3V), R1.1, R4.1, R5.1, R7.1, R8.1, R9.1, R10.1, R11.1, R12.1, R13.2, R14.2, R15.2, R16.2, R17.2, R18.1, R19.1, R20.1, R21.1, R22.1, R23.1, R24.1, R25.1, R26.1, R27.1, U1.24 (VCC); also elsewhere on the board
/A5: J4-OffTheShelf-Digital1.1, LOLIN_C3_PICO1.15 (5_-_A5)
/GPIO4_LED: J4-OffTheShelf-Digital1.5, LOLIN_C3_PICO1.4 (7_-_RGB_LED)
/GPIO20_RX: J4-OffTheShelf-Digital1.7, LOLIN_C3_PICO1.7 (20_-_RX)
/GPIO21_TX: J4-OffTheShelf-Digital1.9, LOLIN_C3_PICO1.8 (21_-_TX)
/SCL: J4-OffTheShelf-Digital1.8, LOLIN_C3_PICO1.6 (10_-_SCL), R1.2, U1.22 (SCL)
/SCL_mult: FB2.2, R24.2, U1.14 (SC4)
/SDA: J4-OffTheShelf-Digital1.6, LOLIN_C3_PICO1.5 (8_-_SDA), R4.2, U1.23 (SDA)
/SDA_mult: FB1.1, R25.2, U1.13 (SD4)
/SPI_CS: J4-OffTheShelf-Digital1.3, LOLIN_C3_PICO1.3 (6)
GND: C1.1, C2.1, C3.2, C4.1, C5.1, D1.1 (A1), D2.1 (A1), D3.1 (A1), D4.1 (A1), D5.1 (A1), D6.1 (A1), J1.1, J1.3, J1.5, J1.7, J1.9, J2.2, J3.2, J3.6, J4.3, J4.4, J4.11, J4.12, J4-OffTheShelf-Digital1.4, J5-Power1.3, J5-Power2.3, LOLIN_C3_PICO1.2 (GND), U1.12 (GND), U2.3 (-Vout); also elsewhere on the board
GND_12V: J3-MagneticInterconnect1.2, T1.4 (G), U2.1 (-Vin); also elsewhere on the board
unnamed 12: D1.2 (A2), FB2.1, J3-MagneticInterconnect1.4; also elsewhere on the board
unnamed 13: D2.2 (A2), FB1.2, J3-MagneticInterconnect1.3; also elsewhere on the board
unnamed: D3.2 (A2), FB3.2, J4.5, R8.2
unnamed: D4.2 (A2), FB4.2, J4.7, R7.2
unnamed: D5.2 (A2), FB5.2, J4.15, R11.2
unnamed: D6.2 (A2), FB6.2, J4.13, R12.2
unnamed: J1.2, LOLIN_C3_PICO1.10 (3_-_A3_-_VBAT), R17.1
unnamed: J1.4, LOLIN_C3_PICO1.11 (2_-_A2), R16.1
unnamed: J1.6, LOLIN_C3_PICO1.12 (1_-_A1_-_SCK), R15.1
unnamed: J1.8, LOLIN_C3_PICO1.13 (0_-_A0_-_MISO), R14.1
unnamed: J1.10, LOLIN_C3_PICO1.14 (4_-_A4_-_MOSI), R13.1
unnamed: J2.3, R26.2, U1.16 (SC5)
unnamed: J2.4, R27.2, U1.15 (SD5)
unnamed: J3.3, R22.2, U1.20 (SC7)
unnamed: J3.4, R23.2, U1.19 (SD7)
unnamed: J3.7, R20.2, U1.18 (SC6)
unnamed: J3.8, R21.2, U1.17 (SD6)
unnamed: J4.6, R10.2, U1.7 (SC1)
unnamed: J4.8, R9.2, U1.6 (SD1)
unnamed: J4.14, R19.2, U1.11 (SC3)
unnamed: J4.16, R18.2, U1.10 (SD3)
unnamed: F1.2, T1.5 (D)
unnamed: T1.1 (S), U2.2 (+Vin)
unnamed: FB3.1, U1.5 (SC0)
unnamed: FB6.1, U1.9 (SC2)
unnamed: FB4.1, U1.4 (SD0)
unnamed: FB5.1, U1.8 (SD2)
unnamed: R5.2, U1.3 (~RESET)
VDD: C1.2, C4.2, J5-Power1.1, J5-Power2.1, LOLIN_C3_PICO1.1 (VIN), U2.4 (+Vout); also elsewhere on the board
VDD_12V: F1.1, J3-MagneticInterconnect1.1; also elsewhere on the board

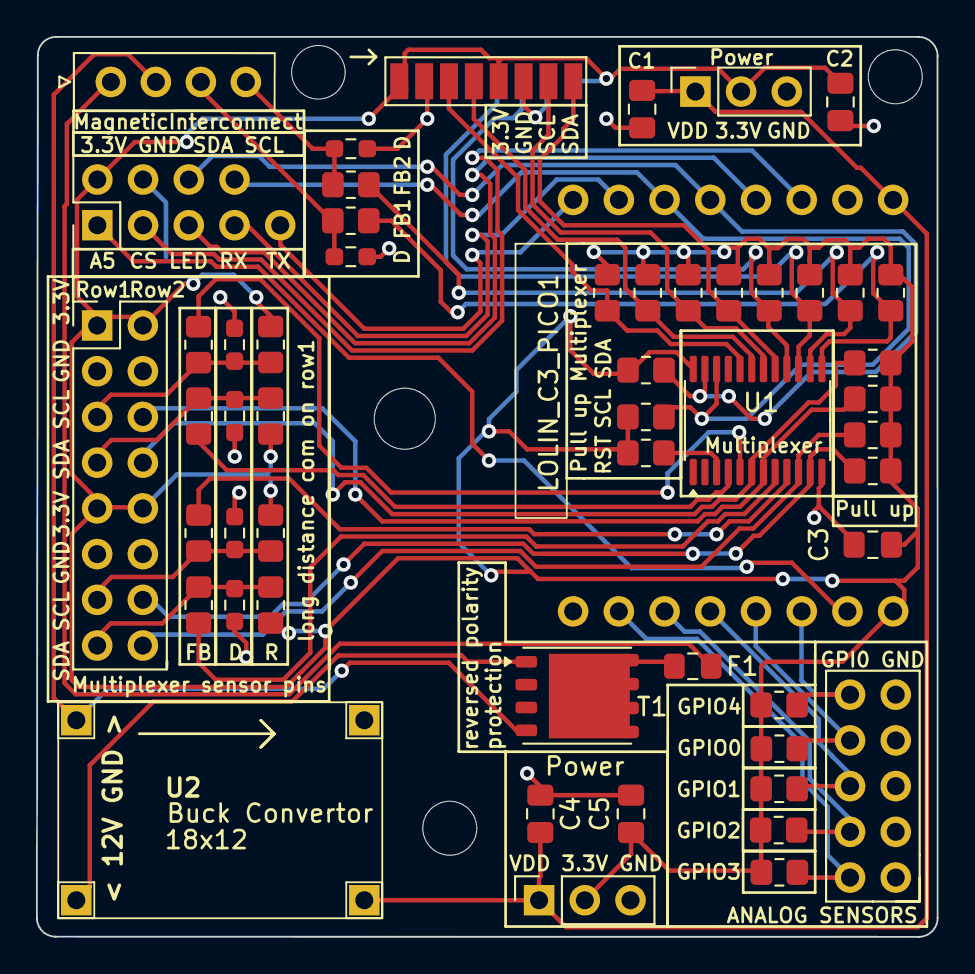
[picture p70: board EHealth_PCB.kicad_pcb from above]

Board: 2 copper layers, 50.0 x 50.0 mm, 54 parts (1 on the bottom side), 42 nets.

Other parts of the board:
MagneticInterconnect: Conn_01x08; JST_VH_B4P-VH-B_1x04_P3.96mm_Vertical
Power: Conn_01x03; PinSocket_1x03_P2.54mm_Vertical
Power#2: Conn_01x03; PinSocket_1x03_P2.54mm_Vertical

Their connections:
+3.3V: Power.2, Power#2.2; also elsewhere on the board
GND: Power.3, Power#2.3; also elsewhere on the board
GND_12V: MagneticInterconnect.2; also elsewhere on the board
unnamed 12: MagneticInterconnect.4; also elsewhere on the board
unnamed 13: MagneticInterconnect.3; also elsewhere on the board
VDD: Power.1, Power#2.1; also elsewhere on the board
VDD_12V: MagneticInterconnect.1; also elsewhere on the board
