UHasselt-imo-imomec/Hybrid_E-Tattoo-Hub/(commit log)

2024-03-03 Propere code van Thijs uit main gecombineerd met analoge sensor
2024-03-04 Data van ppg sensor met klipper rond vinger
    [ppg_data_met_klipper.xlsx]
2024-03-04 Relocated Data folders
    [Alle sensoren met multiplexer op korte afstand.csv, Alle sensoren met multiplexer op lange afstand.csv, PPG_data op korte afstand.csv, PPG_data op lange afstand zonder LTC.csv, PPG_data op super lange afstand met LTC zonder mult.csv, PPG_data op super lange afstand zonder LTC en zonder Multiplexer.csv, PPG_data op super lange afstand zonder LTC.csv, alleen ppg sensor op korte afstand.csv]
2024-03-06 Added PCB design files
    [EHealth_PCB.kicad_pcb, EHealth_PCB.kicad_sch]
2024-03-10 uitlezen van alle sensoren, plotten in S studio
2024-03-11 werkt: pin5, te doen: code voor 3 sensoren
2024-03-11 code uitlezen 3 temp sensoren, proper maken
2024-03-14 blue led
2024-03-14 RGB led
2024-03-14 Full influxdb code ;et led
2024-03-14 secondje push led
2024-03-15 code up to date, pcb layout aanpassingen
2024-03-16 aangepaste pcb layout
    [EHealth_PCB.kicad_pcb, EHealth_PCB.kicad_sch]
2024-03-16 foto van pcb
2024-03-16 foto pcb
2024-03-19 aangepaste layout
    [EHealth_PCB.kicad_pcb, EHealth_PCB.kicad_sch]
2024-03-20 layout met buck en mult chip
    [EHealth_PCB.kicad_pcb, EHealth_PCB.kicad_sch]
2024-03-22 schema met mult chip en buck convertor
    [EHealth_PCB.kicad_pcb, EHealth_PCB.kicad_sch]
2024-03-25 up to date
    [EHealth_PCB.kicad_pcb, EHealth_PCB.kicad_sch]
2024-03-28 huidige layout
    [EHealth_PCB.kicad_pcb, EHealth_PCB.kicad_sch]
2024-03-29 finished layout met logo
    [EHealth_PCB.kicad_pcb]
2024-03-29 Added fabrication files for hub v2 + small reorganisation.
    [EHealth_PCB-B_Cu.gbr, EHealth_PCB-B_Mask.gbr, EHealth_PCB-B_Silkscreen.gbr, EHealth_PCB-Edge_Cuts.gbr, EHealth_PCB-F_Cu.gbr, EHealth_PCB-F_Mask.gbr, EHealth_PCB-F_Silkscreen.gbr, EHealth_PCB-NPTH.drl]
2024-04-15 nieuwe pcb
2024-04-17 verbeterde layout
    [EHealth_PCB.kicad_pcb, EHealth_PCB.kicad_sch]
2024-04-20 PCB up to date
    [EHealth_PCB.kicad_pcb, EHealth_PCB.kicad_sch]
2024-04-28 Added production files for V2.0
    [EHealth_PCB-B_Cu.gbr, EHealth_PCB-B_Mask.gbr, EHealth_PCB-B_Silkscreen.gbr, EHealth_PCB-Edge_Cuts.gbr, EHealth_PCB-F_Cu.gbr, EHealth_PCB-F_Mask.gbr, EHealth_PCB-F_Silkscreen.gbr, EHealth_PCB-NPTH.drl]
2024-07-20 New PCB
    [EHealth_PCB.kicad_pcb]
2024-10-08 Reshuffeled Hardware designfiles
    [BOM.xls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]
